Yang-xy-svg/ESP_OpenMic/(list of files, cad)

Other CAD files:
PCB/Recorder/RecorderBatNoTagT.stl
PCB/Recorder/RecorderBatNoTagC.stl
PCB/Recorder/RecorderBatNoTagB.stl
PCB/Recorder/RecorderBatNoTagC.scad
PCB/Recorder/RecorderBatNoTagT.scad
