Yang-xy-svg/ESP_OpenMic/(commit log)

2026-10-20 OpenMic ESP32 project snapshot
    Firmware for ESP32-S3 based OpenMic hardware. Based on
    https://codeberg.org/RevK/ESP32-OpenMic (revision 06d4d71), with local
    fixes for building against current ESP-IDF.
2026-10-20 新增录音上传WAV格式至手机电脑
2026-10-26 新增蓝牙待机，关闭MQTT，成功连接
